PRDV1/Manual_BJP/README.md

# Manual_BJP
Manual binder jet 3D printer designed to enable small-scale research, multi-material structures, and interchangeable binder deposition methods
