PRDV1/Manual_BJP/CAD_files/II. Ink-Cartridge_Top_Plate/Ink-Cartridge_top_plate_assembly.SLDASM

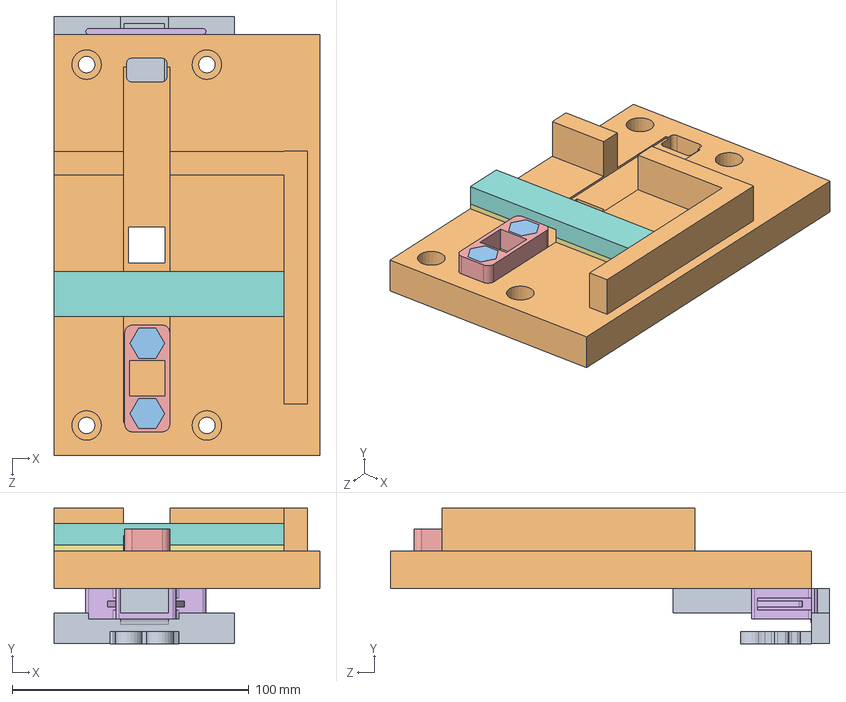
[picture p5: CAD file, 2024-03-27]
CAD_files/II. Ink-Cartridge_Top_Plate/Ink-Cartridge_top_plate_assembly.SLDASM
112.2 x 57.2 x 185.4 mm
Ink-Cartridge_Top_Plate
Brass_insert_powder_carriage x 2
Felt_powder_carriage
Powder_carriage
Felt_powder_spreader_Ink-Cartridge
Powder_spreader_Ink-Cartridge
Powder_catcher_short_both
