PRDV1/Manual_BJP/CAD_files/III. Stage_Assembly/Stage_assembly_support_4108.SLDPRT

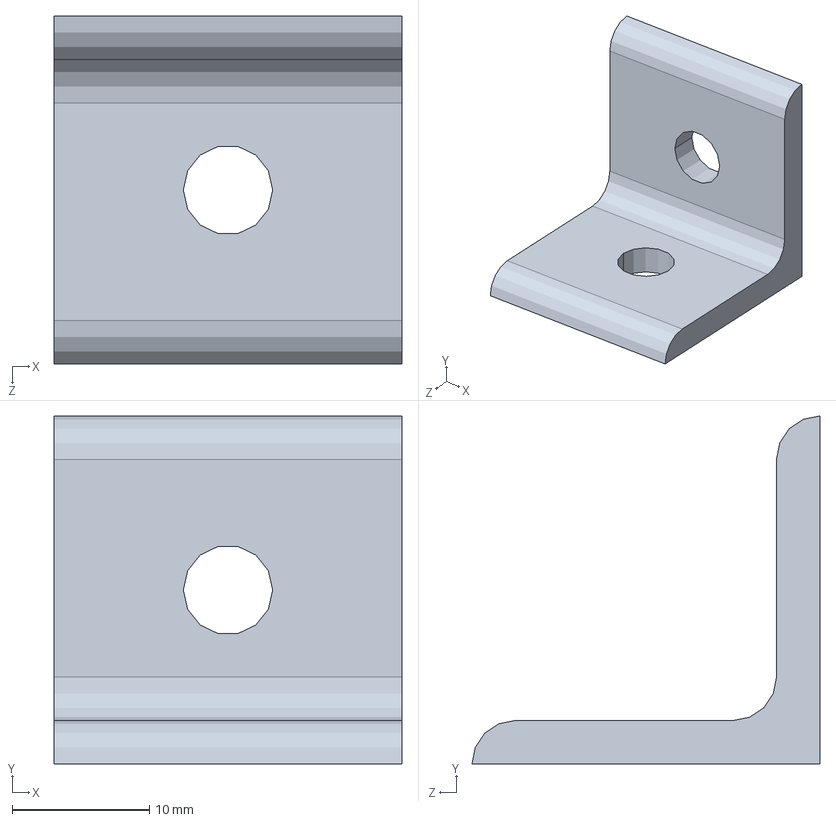
[picture p6: CAD file, 2024-03-27]
CAD_files/III. Stage_Assembly/Stage_assembly_support_4108.SLDPRT
25.4 x 25.4 x 25.4 mm
