PRDV1/Manual_BJP/STL_files/I. Spray_Top_Plate/Spray_top_plate_assembly-Powder_carriage_assembly-1 Powder_carriage.STL

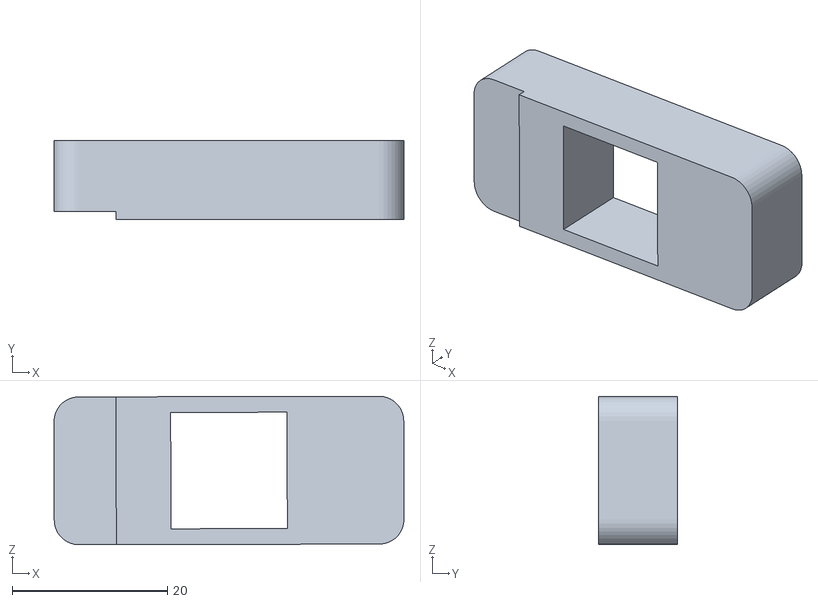
[picture p7: CAD file, 2024-03-27]
STL_files/I. Spray_Top_Plate/Spray_top_plate_assembly-Powder_carriage_assembly-1 Powder_carriage.STL
45.1 x 10.2 x 19.1
