PRDV1/Manual_BJP/STL_files/II. Ink-Cartridge_Top_Plate/Ink-Cartridge_top_plate_assembly-Powder_spreader_Ink-Cartridge_assembly-1 Felt_powder_spreader_Ink-Cartridge.STL

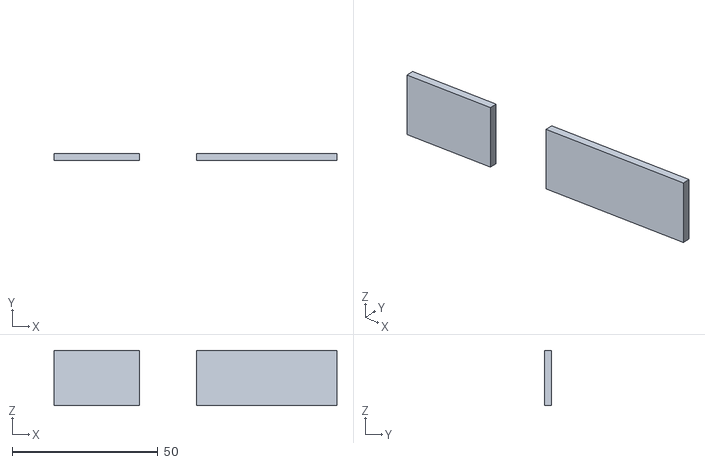
[picture p8: CAD file, 2024-03-27]
STL_files/II. Ink-Cartridge_Top_Plate/Ink-Cartridge_top_plate_assembly-Powder_spreader_Ink-Cartridge_assembly-1 Felt_powder_spreader_Ink-Cartridge.STL
97.0 x 2.50 x 19.0
