PRDV1/Manual_BJP/STL_files/III. Stage_Assembly/Stage_assembly-Steel_ball.STL

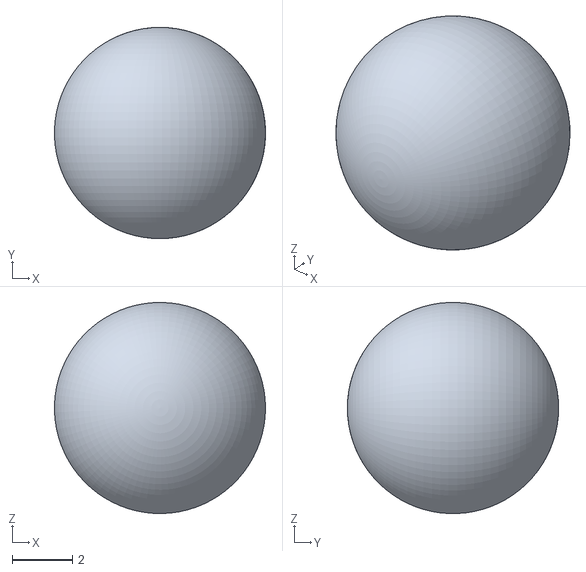
[picture p9: CAD file, 2024-03-27]
STL_files/III. Stage_Assembly/Stage_assembly-Steel_ball.STL
6.99 x 7.00 x 6.99
