PRDV1/Manual_BJP/STL_files/IV. Heat_lamp/Heat_lamp_assembly-Lamp.STL

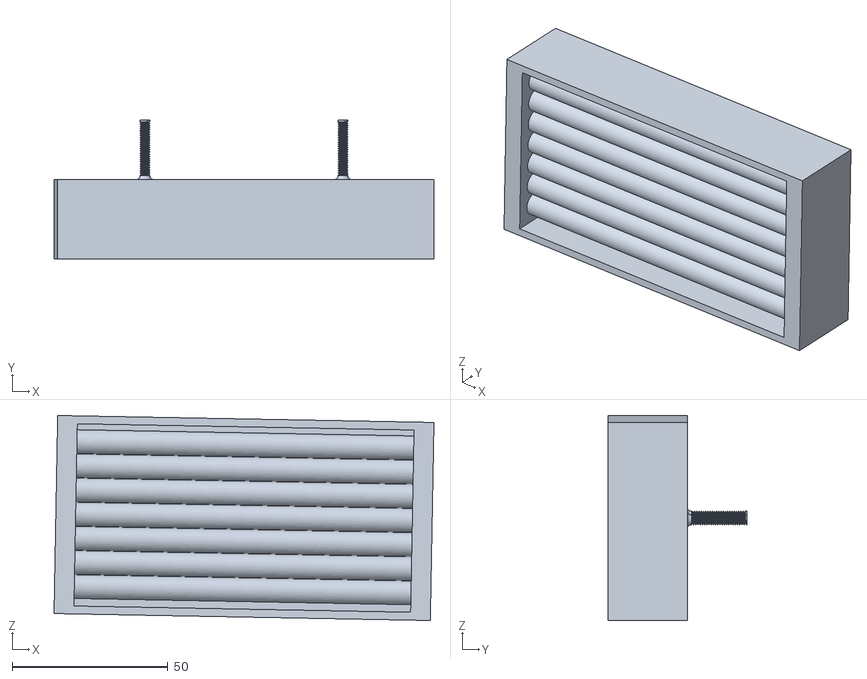
[picture p10: CAD file, 2024-03-27]
STL_files/IV. Heat_lamp/Heat_lamp_assembly-Lamp.STL
121.8 x 44.5 x 65.7
