PRDV1/Manual_BJP/STL_files/Stage/Frame_assembly-Base.STL

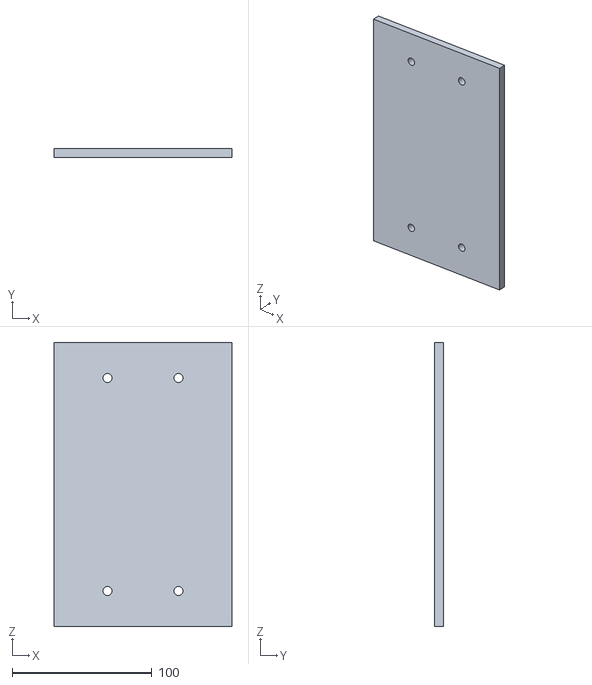
[picture p11: CAD file, 2024-03-27]
STL_files/Stage/Frame_assembly-Base.STL
127.0 x 6.35 x 203.2
