PRDV1/Manual_BJP/STL_files/V. Transfer_Assembly/Transfer_assembly-Transfer_slider.STL

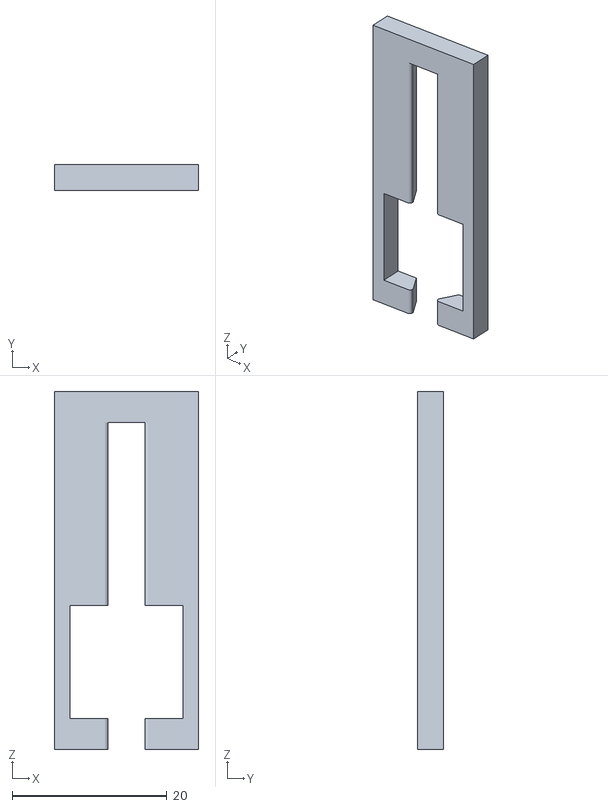
[picture p12: CAD file, 2024-03-27]
STL_files/V. Transfer_Assembly/Transfer_assembly-Transfer_slider.STL
18.6 x 3.40 x 46.2
