PRDV1/Manual_BJP/CAD_files/I. Spray_Top_Plate/Spray_top_plate_assembly.SLDASM

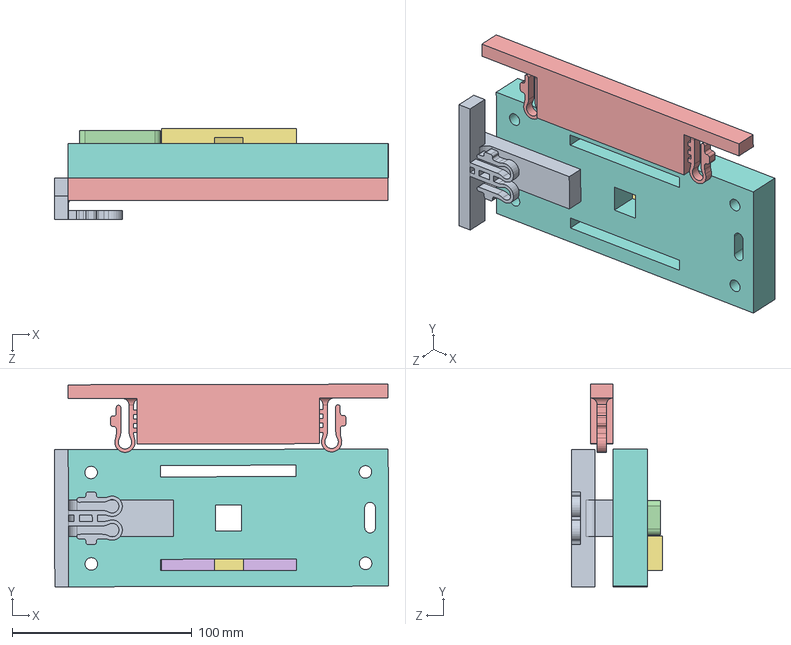
[picture p13: CAD file, 2024-03-27]
CAD_files/I. Spray_Top_Plate/Spray_top_plate_assembly.SLDASM
185.6 x 112.7 x 50.8 mm
Brass_insert_powder_carriage x 2
Felt_powder_carriage
Powder_carriage
Powder_catcher_long_Spray
Felt_powder_spreader_Spray
Powder_spreader_Spray
Spray_top_plate
Powder_catcher_short_both
