PRDV1/Manual_BJP/CAD_files/IV. Heat_lamp/Heat_lamp_assembly.SLDASM

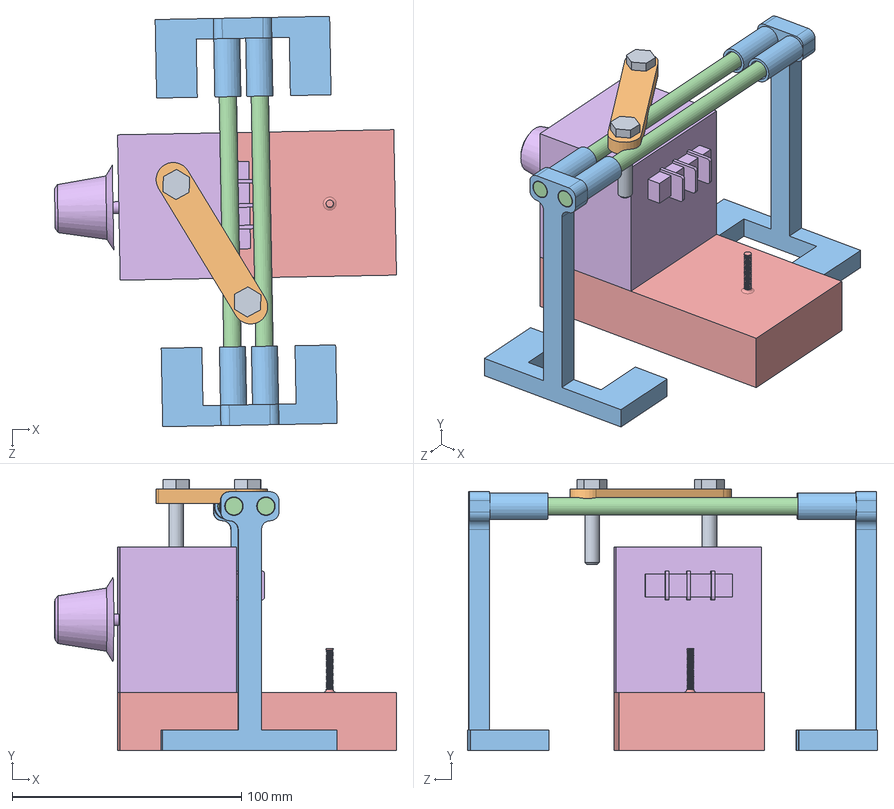
[picture p14: CAD file, 2024-03-27]
CAD_files/IV. Heat_lamp/Heat_lamp_assembly.SLDASM
149.3 x 118.4 x 179.2 mm
Bolt_heat_lamp x 2
Heat_lamp_standholder
Heat_lamp_standpost x 2
Heat_lamp_standrod x 2
Lamp
Lamp_voltage_regulator
