PRDV1/Manual_BJP/CAD_files/Stage/Frame_assembly2.SLDASM

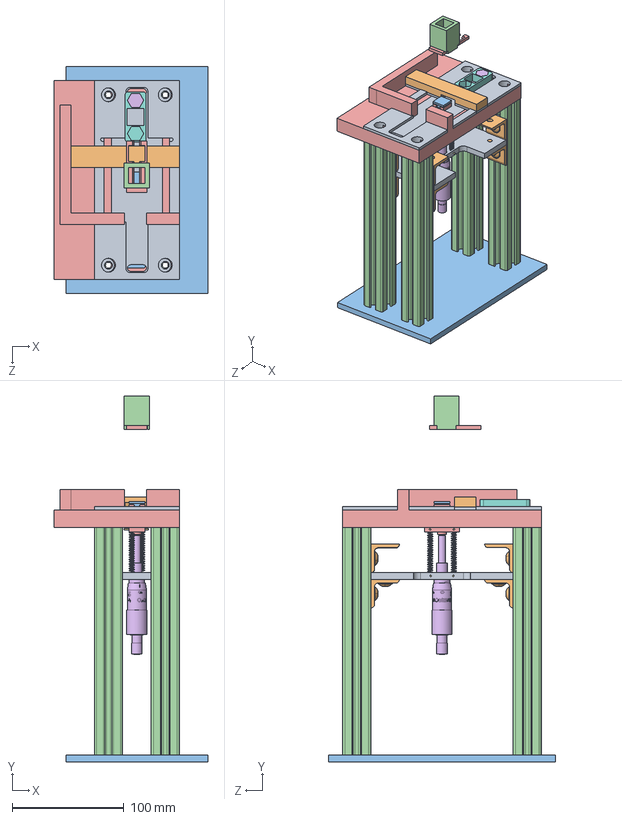
[picture p15: CAD file, 2024-03-27]
CAD_files/Stage/Frame_assembly2.SLDASM
137.6 x 327.3 x 203.2 mm
Base
Railed_post x 4
Build_bed_support
Mitutoyo Micrometer 150-831
Pin_stage_assembly x 4
Spring x 2
Stage_assembly_platform
Stage_assembly_screw_3390 x 12
Stage_assembly_slider_3382 x 8
Stage_assembly_support_4108 x 8
Stee_ball
Build_plate
Spray_top_plate
