PRDV1/Manual_BJP/STL_files/I. Spray_Top_Plate/Spray_top_plate_assembly-Spray_top_plate.STL

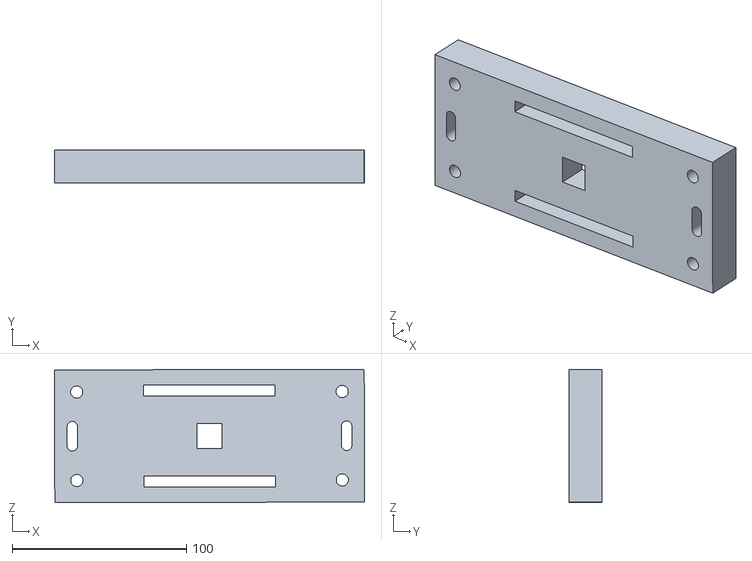
[picture p16: CAD file, 2024-03-27]
STL_files/I. Spray_Top_Plate/Spray_top_plate_assembly-Spray_top_plate.STL
178.0 x 19.0 x 76.6
