PRDV1/Manual_BJP/STL_files/III. Stage_Assembly/Stage_assembly-Pin_stage_assembly.STL

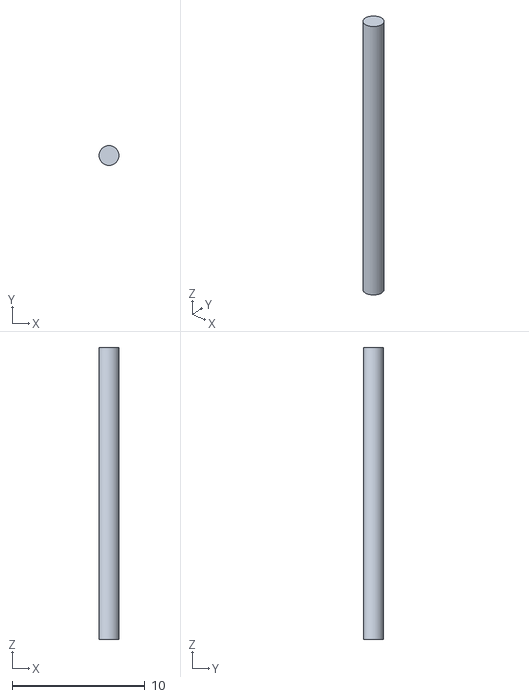
[picture p17: CAD file, 2024-03-27]
STL_files/III. Stage_Assembly/Stage_assembly-Pin_stage_assembly.STL
1.50 x 1.50 x 22.0
