PRDV1/Manual_BJP/STL_files/IV. Heat_lamp/Heat_lamp_assembly-Heat_lamp_standpost.STL

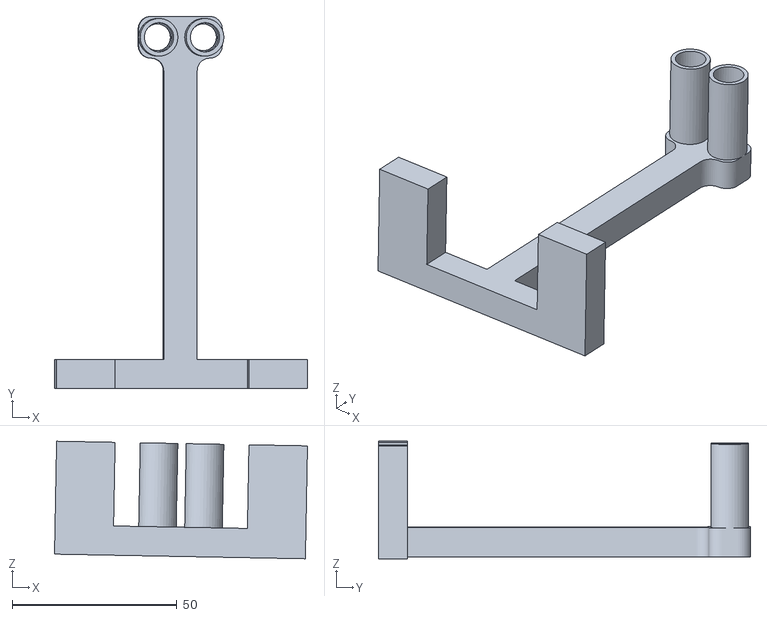
[picture p18: CAD file, 2024-03-27]
STL_files/IV. Heat_lamp/Heat_lamp_assembly-Heat_lamp_standpost.STL
76.8 x 113.0 x 35.7
