PRDV1/Manual_BJP/STL_files/Stage/Frame_assembly-slider_3382.STL

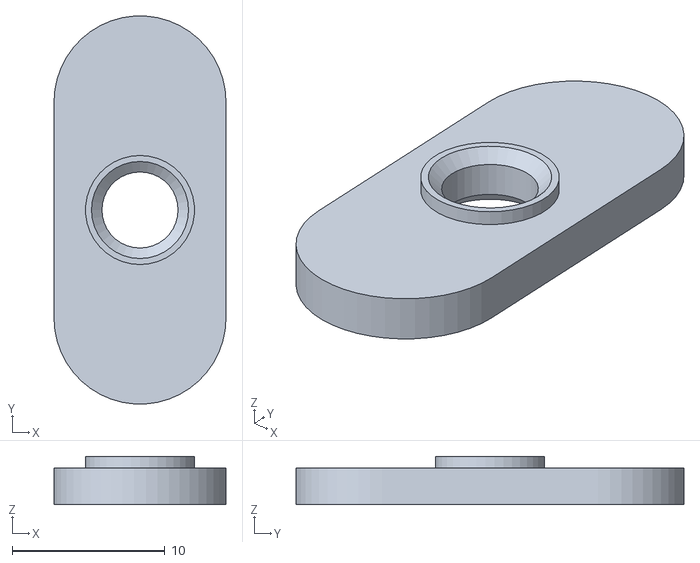
[picture p19: CAD file, 2024-03-27]
STL_files/Stage/Frame_assembly-slider_3382.STL
11.3 x 25.4 x 3.15
