PRDV1/Manual_BJP/STL_files/V. Transfer_Assembly/Transfer_assembly-Transfer_box.STL

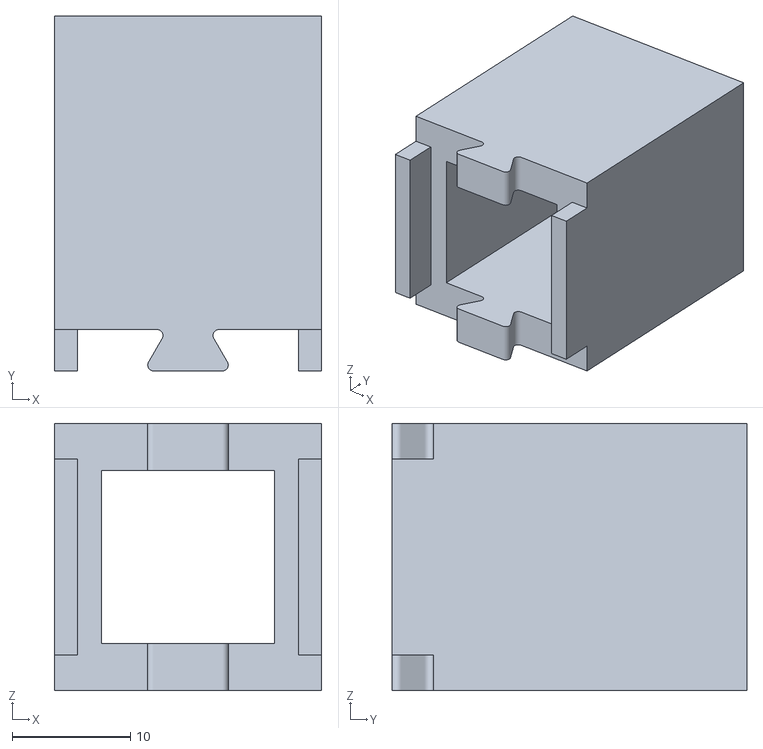
[picture p20: CAD file, 2024-03-27]
STL_files/V. Transfer_Assembly/Transfer_assembly-Transfer_box.STL
22.6 x 30.0 x 22.6
