PRDV1/Manual_BJP/STL_files/II. Ink-Cartridge_Top_Plate/Ink-Cartridge_top_plate_assembly-Ink-Cartridge_Top_Plate.STL

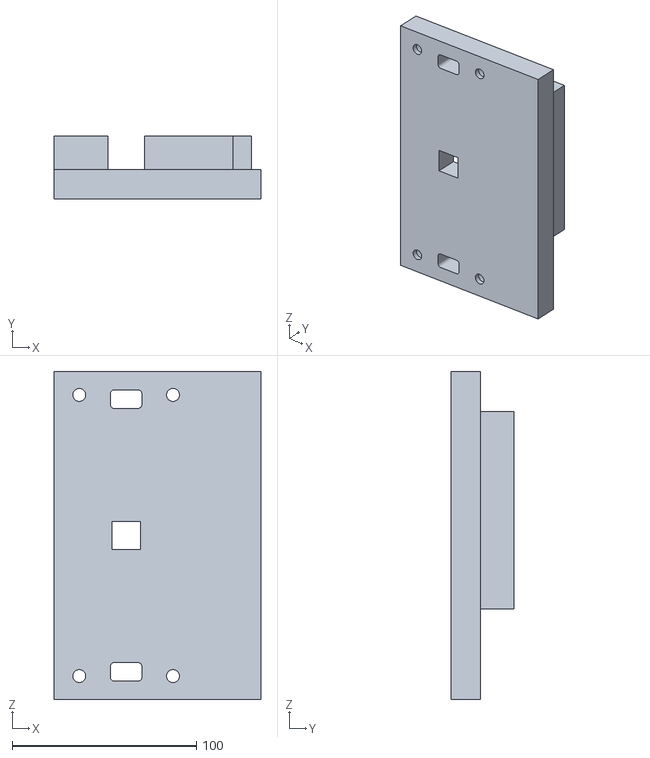
[picture p23: CAD file, 2024-03-27]
STL_files/II. Ink-Cartridge_Top_Plate/Ink-Cartridge_top_plate_assembly-Ink-Cartridge_Top_Plate.STL
112.2 x 34.0 x 177.8
