PRDV1/Manual_BJP/STL_files/V. Transfer_Assembly/Transfer_assembly-Build_plate.STL

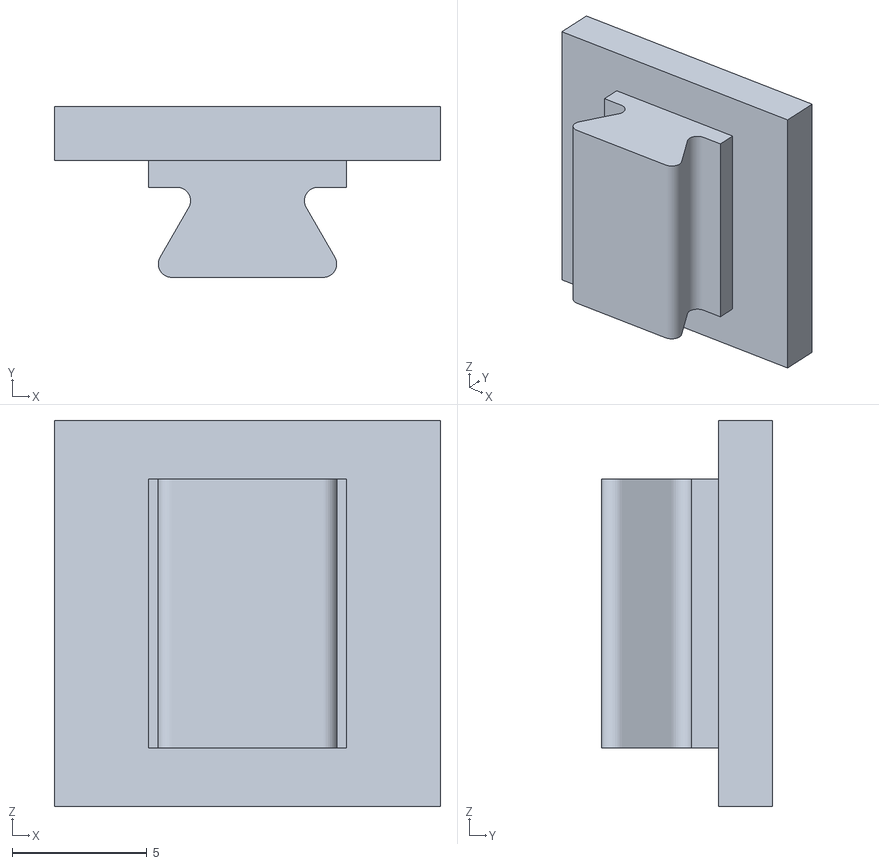
[picture p24: CAD file, 2024-03-27]
STL_files/V. Transfer_Assembly/Transfer_assembly-Build_plate.STL
14.3 x 6.35 x 14.4
