PRDV1/Manual_BJP/CAD_files/I. Spray_Top_Plate/Powder_deposition_and_spreading/Powder_spreader_Spray_assembly.SLDASM

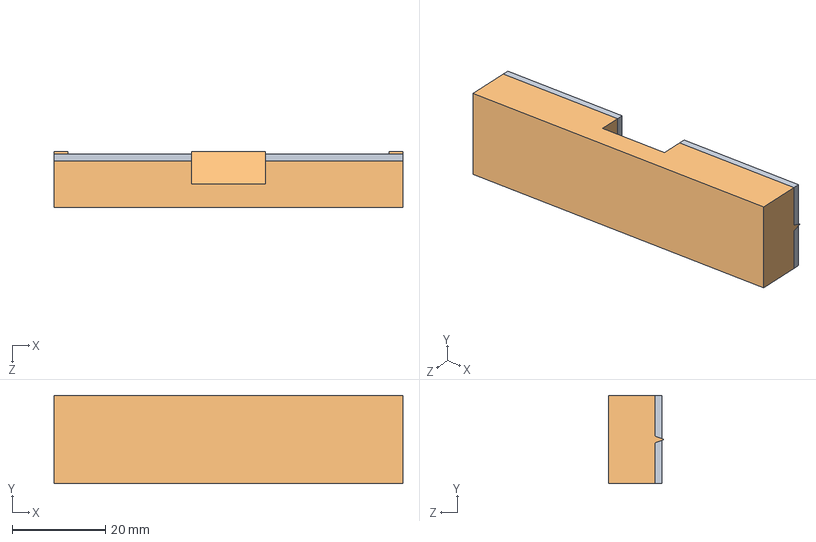
[picture p25: CAD file, 2024-03-27]
CAD_files/I. Spray_Top_Plate/Powder_deposition_and_spreading/Powder_spreader_Spray_assembly.SLDASM
75.0 x 19.0 x 12.0 mm
Felt_powder_spreader_Spray
Powder_spreader_Spray
