PRDV1/Manual_BJP/CAD_files/Stage/support_assembly.SLDASM

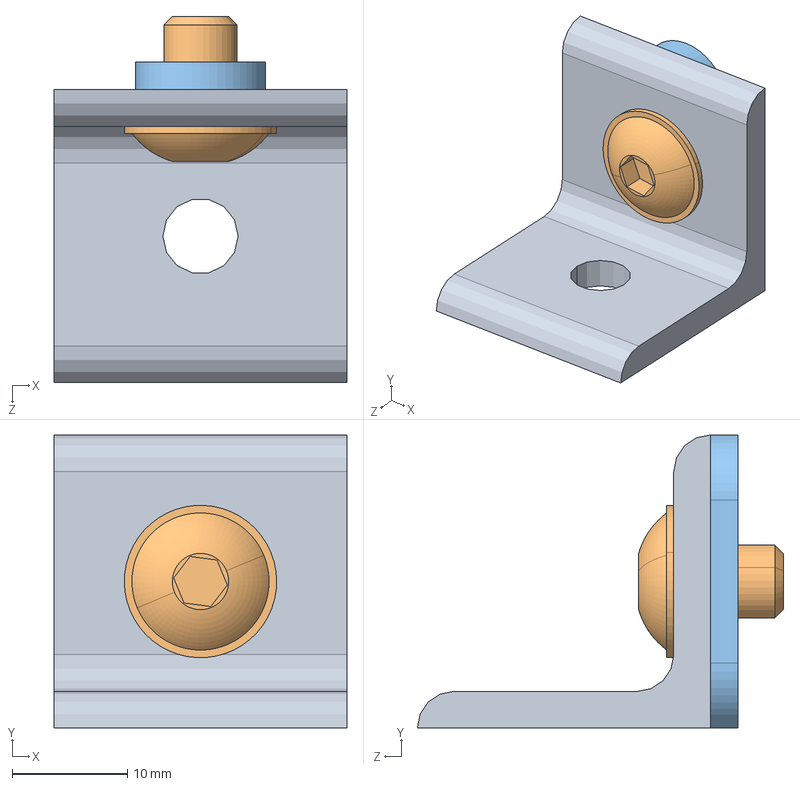
[picture p26: CAD file, 2024-03-27]
CAD_files/Stage/support_assembly.SLDASM
25.4 x 25.4 x 31.7 mm
Stage_assembly_screw_3390
Stage_assembly_slider_3382
Stage_assembly_support_4108
