PRDV1/Manual_BJP/CAD_files/V. Transfer_Assembly/Transfer_assembly.SLDASM

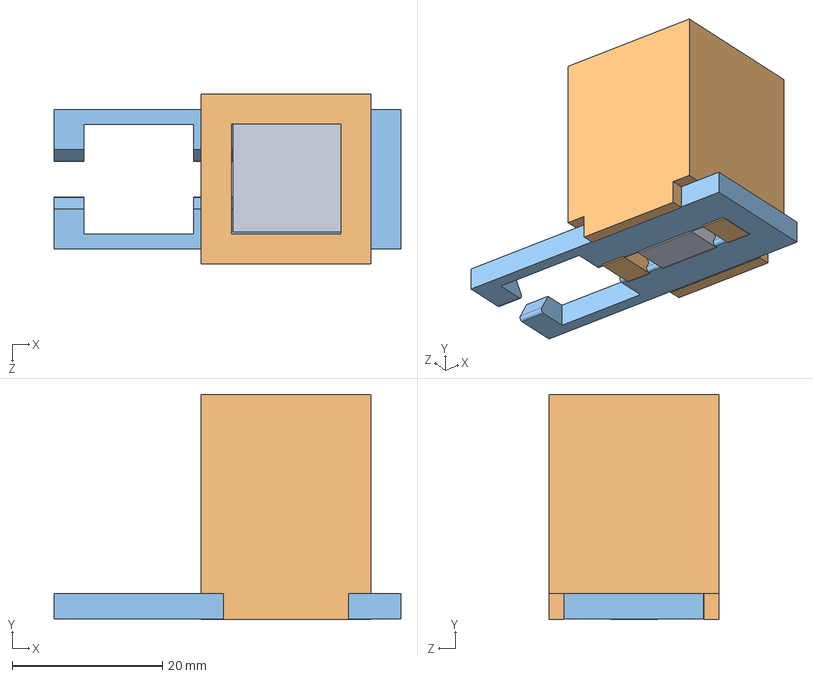
[picture p27: CAD file, 2024-03-27]
CAD_files/V. Transfer_Assembly/Transfer_assembly.SLDASM
46.2 x 30.0 x 22.6 mm
Build_plate
Transfer_box
Transfer_slider
