PRDV1/Manual_BJP/STL_files/I. Spray_Top_Plate/Spray_top_plate_assembly-Powder_spreader_Spray_assembly-1 Felt_powder_spreader_Spray.STL

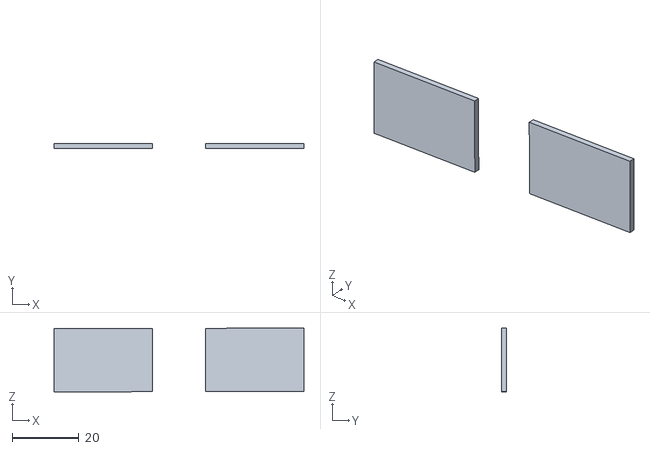
[picture p28: CAD file, 2024-03-27]
STL_files/I. Spray_Top_Plate/Spray_top_plate_assembly-Powder_spreader_Spray_assembly-1 Felt_powder_spreader_Spray.STL
75.0 x 1.50 x 19.2
