PRDV1/Manual_BJP/STL_files/II. Ink-Cartridge_Top_Plate/Ink-Cartridge_top_plate_assembly-Powder_carriage_assembly-1 Brass_insert_powder_carriage.STL

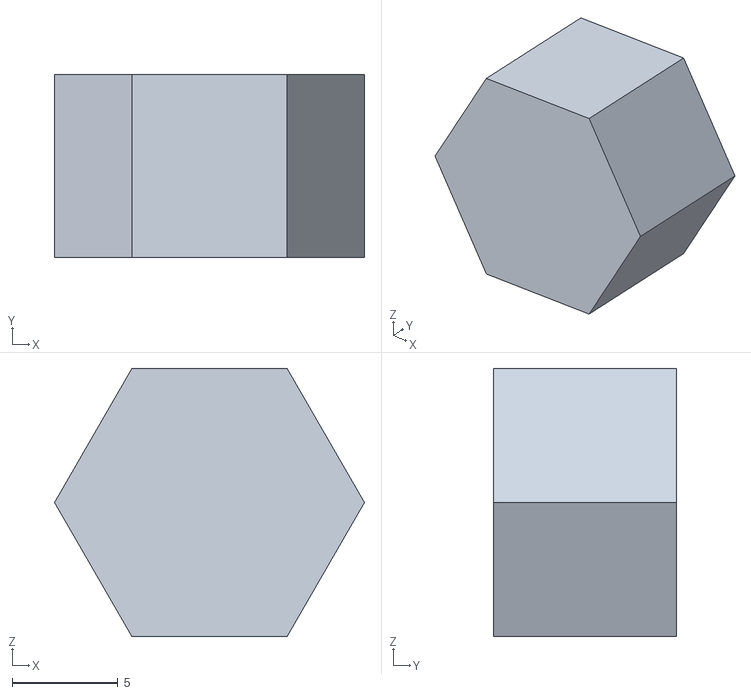
[picture p29: CAD file, 2024-03-27]
STL_files/II. Ink-Cartridge_Top_Plate/Ink-Cartridge_top_plate_assembly-Powder_carriage_assembly-1 Brass_insert_powder_carriage.STL
14.7 x 8.64 x 12.7
