PRDV1/Manual_BJP/STL_files/IV. Heat_lamp/Heat_lamp_assembly-Heat_lamp_standholder.STL

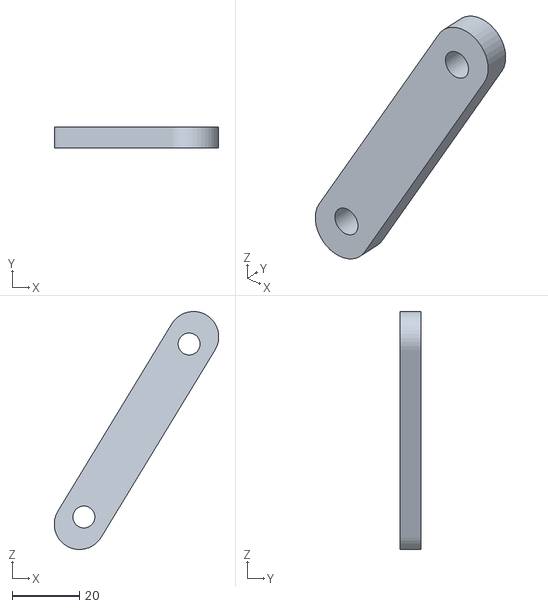
[picture p30: CAD file, 2024-03-27]
STL_files/IV. Heat_lamp/Heat_lamp_assembly-Heat_lamp_standholder.STL
48.7 x 6.35 x 70.5
