PRDV1/Manual_BJP/STL_files/Stage/Frame_assembly-Railed_post.STL

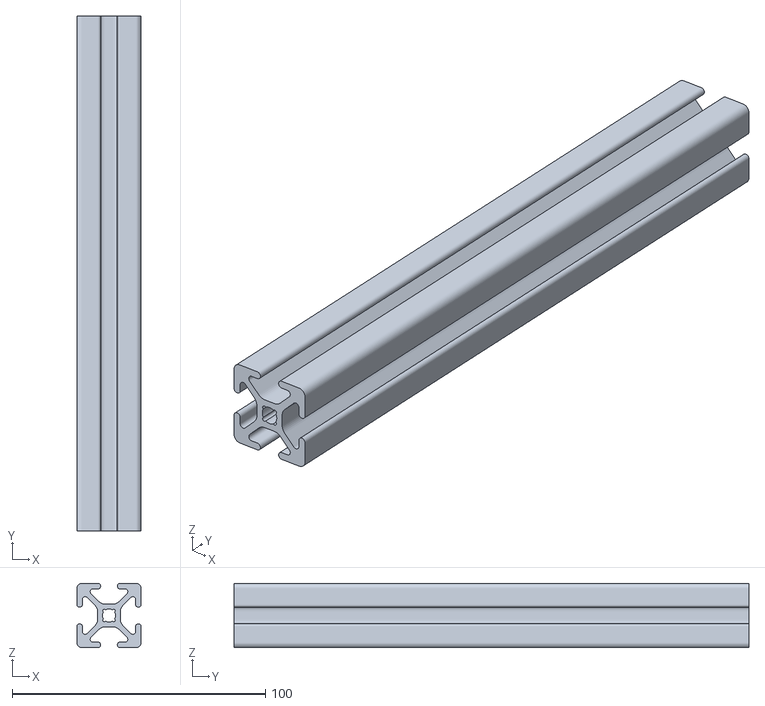
[picture p31: CAD file, 2024-03-27]
STL_files/Stage/Frame_assembly-Railed_post.STL
25.4 x 203.2 x 25.4
