PRDV1/Manual_BJP/CAD_files/II. Ink-Cartridge_Top_Plate/Powder_deposition_and_spreading/Powder_spreader_Ink-Cartridge_assembly.SLDASM

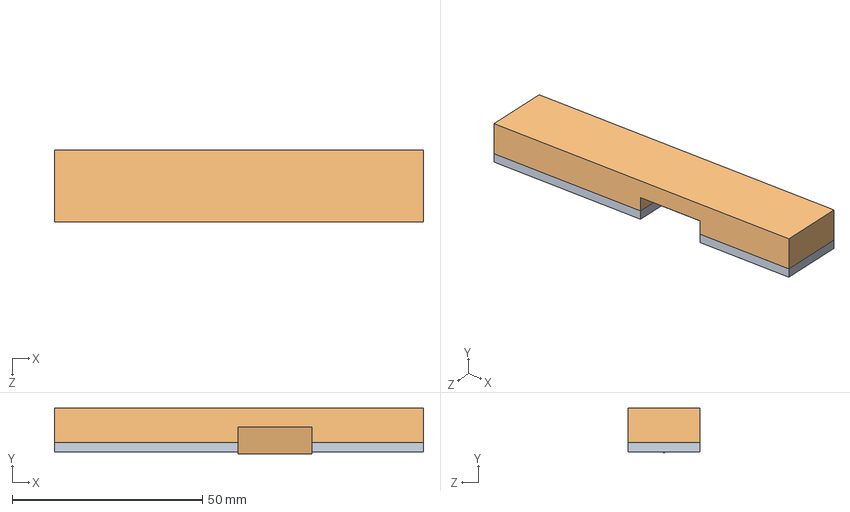
[picture p32: CAD file, 2024-03-27]
CAD_files/II. Ink-Cartridge_Top_Plate/Powder_deposition_and_spreading/Powder_spreader_Ink-Cartridge_assembly.SLDASM
97.0 x 12.0 x 19.0 mm
Felt_powder_spreader_Ink-Cartridge
Powder_spreader_Ink-Cartridge
