PRDV1/Manual_BJP/STL_files/I. Spray_Top_Plate/Spray_top_plate_assembly-Powder_catcher_long_Spray.STL

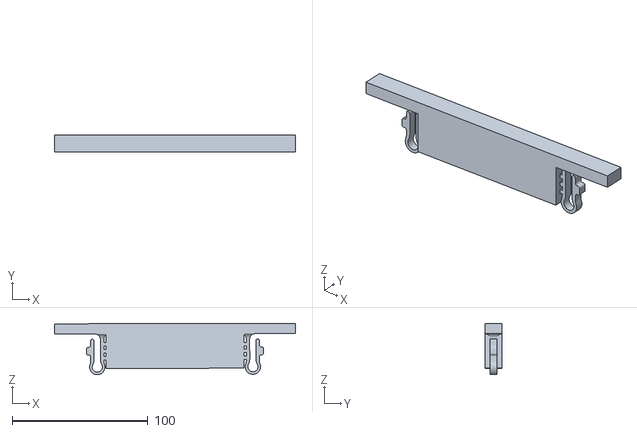
[picture p33: CAD file, 2024-03-27]
STL_files/I. Spray_Top_Plate/Spray_top_plate_assembly-Powder_catcher_long_Spray.STL
177.8 x 12.7 x 37.9
