PRDV1/Manual_BJP/STL_files/II. Ink-Cartridge_Top_Plate/Ink-Cartridge_top_plate_assembly-Powder_spreader_Ink-Cartridge_assembly-1 Powder_spreader_Ink-Cartridge.STL

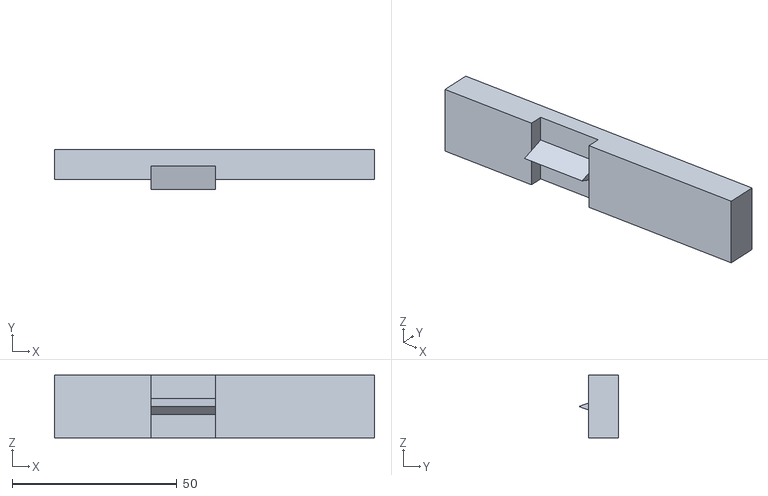
[picture p34: CAD file, 2024-03-27]
STL_files/II. Ink-Cartridge_Top_Plate/Ink-Cartridge_top_plate_assembly-Powder_spreader_Ink-Cartridge_assembly-1 Powder_spreader_Ink-Cartridge.STL
97.0 x 12.0 x 19.0
