PRDV1/Manual_BJP/STL_files/III. Stage_Assembly/Stage_assembly-Mitutoyo Micrometer 150-831.STL

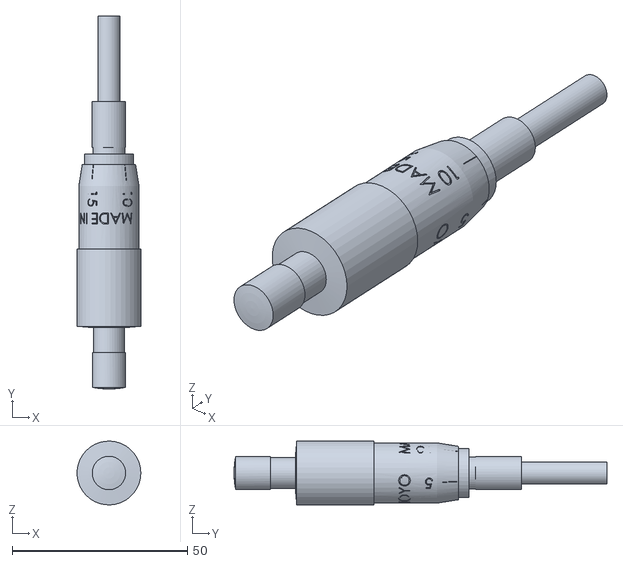
[picture p35: CAD file, 2024-03-27]
STL_files/III. Stage_Assembly/Stage_assembly-Mitutoyo Micrometer 150-831.STL
18.2 x 106.3 x 18.2
