PRDV1/Manual_BJP/STL_files/IV. Heat_lamp/Heat_lamp_assembly-Heat_lamp_standrod.STL

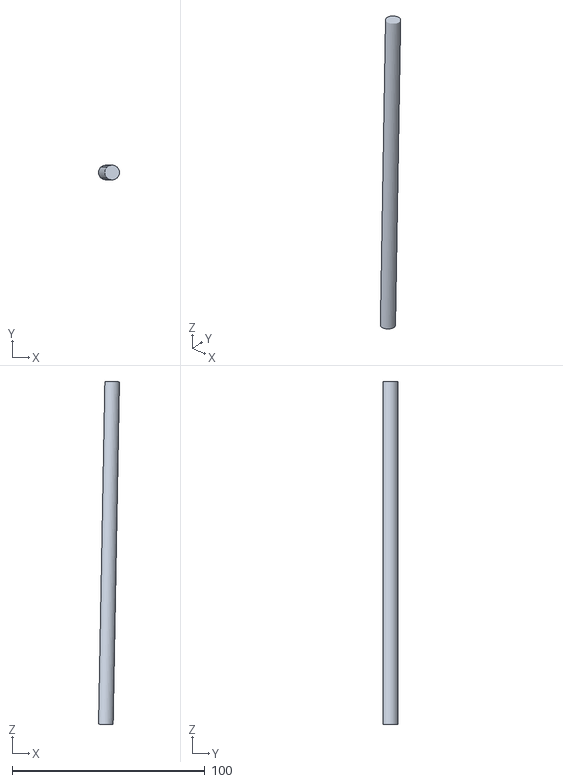
[picture p36: CAD file, 2024-03-27]
STL_files/IV. Heat_lamp/Heat_lamp_assembly-Heat_lamp_standrod.STL
10.9 x 7.61 x 177.9
