PRDV1/Manual_BJP/CAD_files/I. Spray_Top_Plate/Powder_deposition_and_spreading/Powder_carriage_assembly.SLDASM

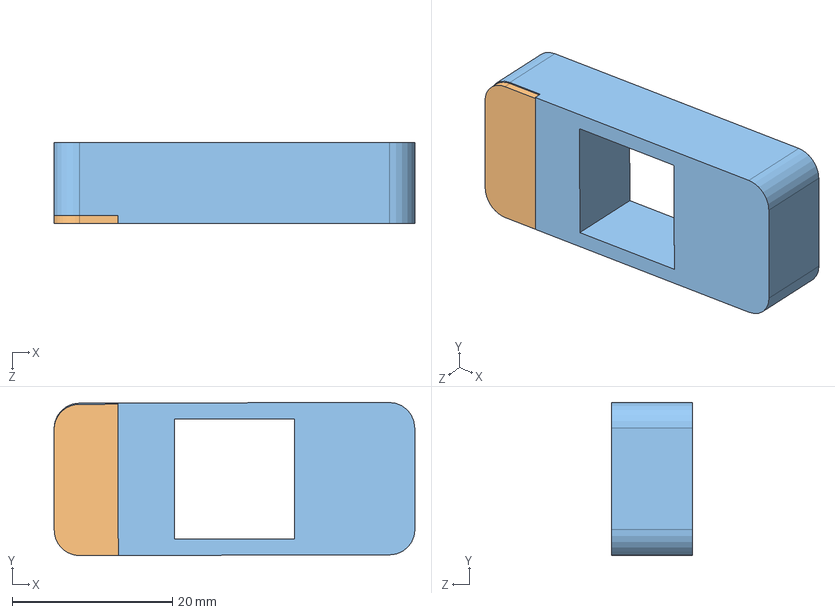
[picture p37: CAD file, 2024-03-27]
CAD_files/I. Spray_Top_Plate/Powder_deposition_and_spreading/Powder_carriage_assembly.SLDASM
45.1 x 19.1 x 10.2 mm
Brass_insert_powder_carriage x 2
Felt_powder_carriage
Powder_carriage
