PRDV1/Manual_BJP/STL_files/I. Spray_Top_Plate/Spray_top_plate_assembly-Powder_carriage_assembly-1 Felt_powder_carriage.STL

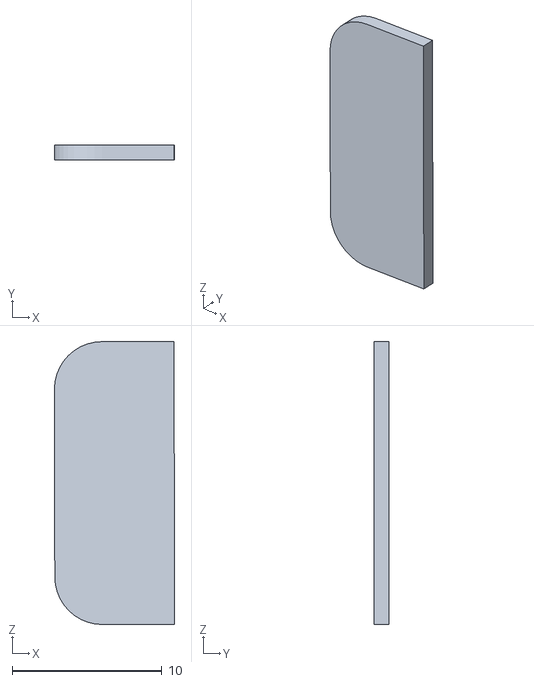
[picture p38: CAD file, 2024-03-27]
STL_files/I. Spray_Top_Plate/Spray_top_plate_assembly-Powder_carriage_assembly-1 Felt_powder_carriage.STL
8.03 x 1.00 x 18.9
