PRDV1/Manual_BJP/STL_files/II. Ink-Cartridge_Top_Plate/Ink-Cartridge_top_plate_assembly-Powder_catcher_short_both.STL

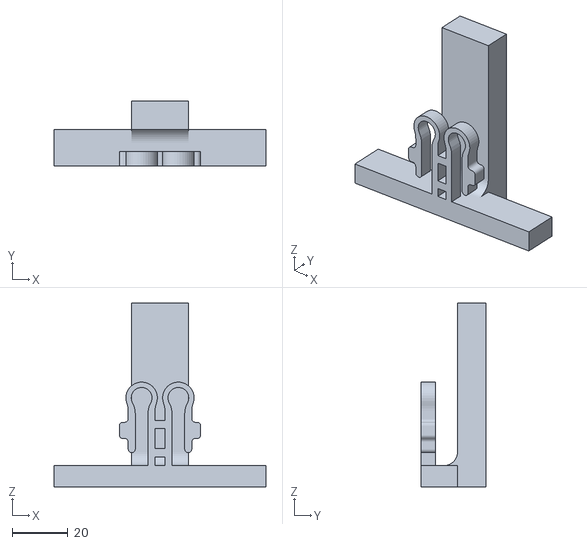
[picture p39: CAD file, 2024-03-27]
STL_files/II. Ink-Cartridge_Top_Plate/Ink-Cartridge_top_plate_assembly-Powder_catcher_short_both.STL
76.2 x 23.2 x 66.0
