PRDV1/Manual_BJP/STL_files/III. Stage_Assembly/Stage_assembly-Build_bed_support.STL

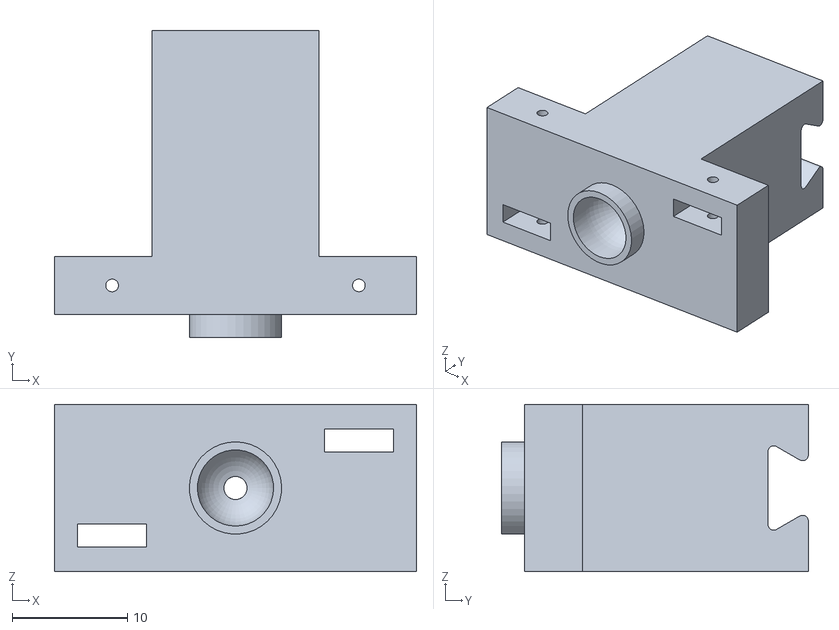
[picture p40: CAD file, 2024-03-27]
STL_files/III. Stage_Assembly/Stage_assembly-Build_bed_support.STL
31.4 x 26.6 x 14.5
