PRDV1/Manual_BJP/STL_files/IV. Heat_lamp/Heat_lamp_assembly-Lamp_voltage_regulator.STL

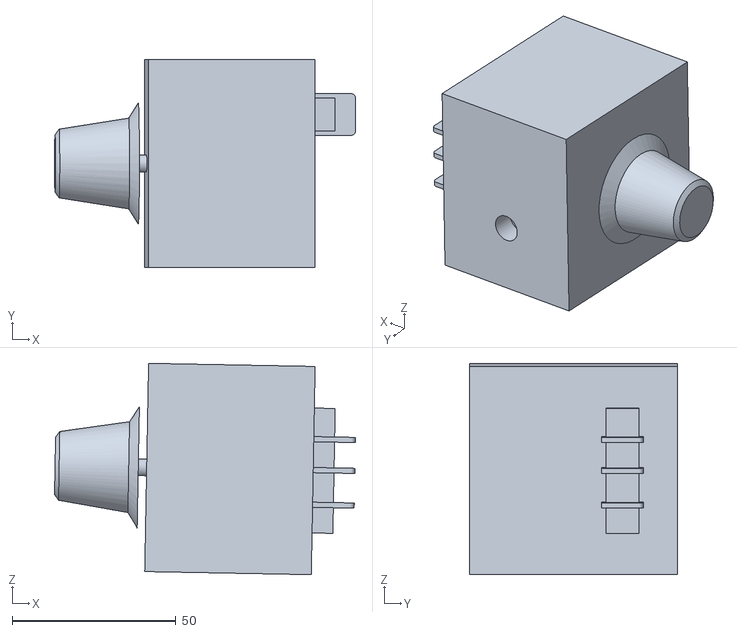
[picture p41: CAD file, 2024-03-27]
STL_files/IV. Heat_lamp/Heat_lamp_assembly-Lamp_voltage_regulator.STL
91.8 x 63.5 x 64.4
