PRDV1/Manual_BJP/CAD_files/III. Stage_Assembly/Stage_assembly_platform.SLDPRT

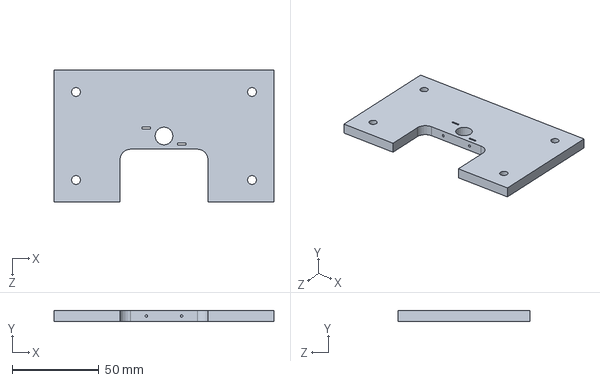
[picture p42: CAD file, 2024-03-27]
CAD_files/III. Stage_Assembly/Stage_assembly_platform.SLDPRT
127.0 x 6.35 x 76.2 mm
