PRDV1/Manual_BJP/CAD_files/III. Stage_Assembly/Stage_assembly.SLDASM

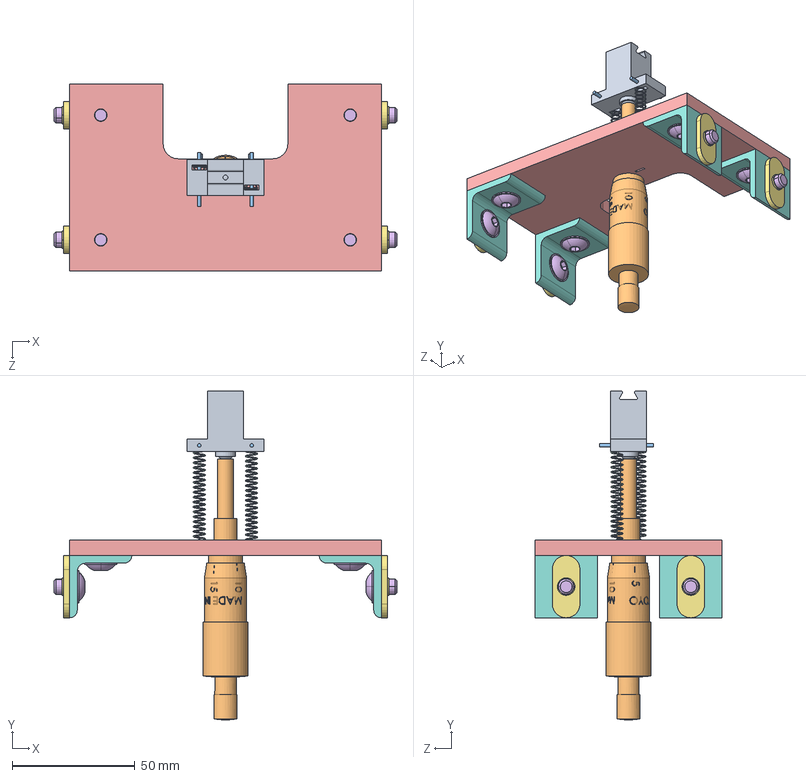
[picture p43: CAD file, 2024-03-27]
CAD_files/III. Stage_Assembly/Stage_assembly.SLDASM
139.7 x 133.9 x 76.2 mm
Build_bed_support
Mitutoyo Micrometer 150-831
Pin_stage_assembly x 4
Spring x 2
Stage_assembly_platform
Stage_assembly_screw_3390 x 8
Stage_assembly_slider_3382 x 4
Stage_assembly_support_4108 x 4
Stee_ball
