PRDV1/Manual_BJP/STL_files/III. Stage_Assembly/Stage_assembly-Spring.STL

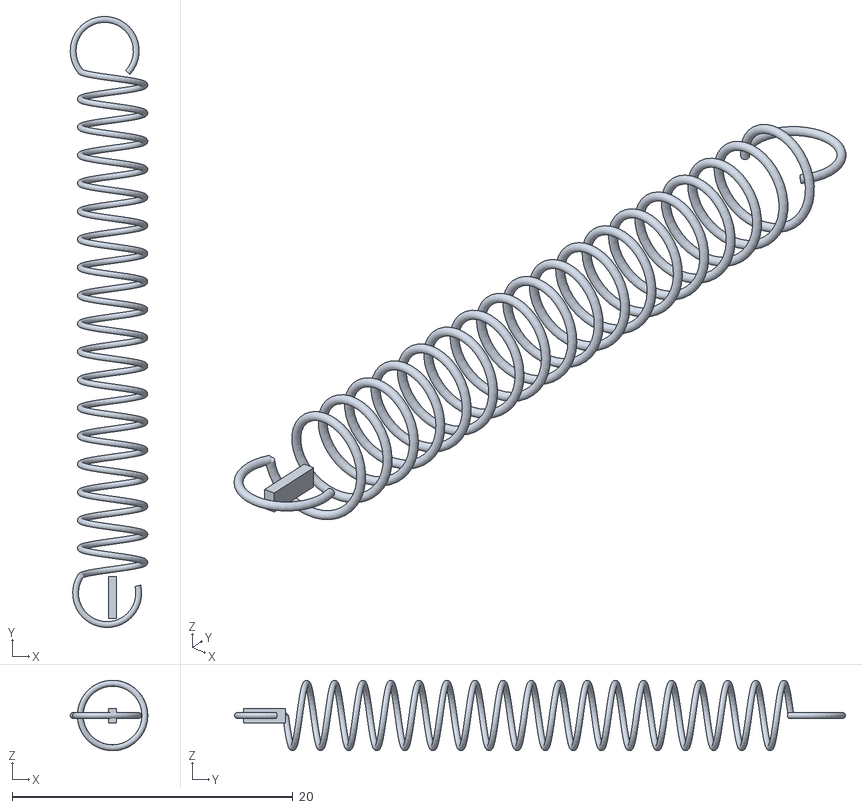
[picture p44: CAD file, 2024-03-27]
STL_files/III. Stage_Assembly/Stage_assembly-Spring.STL
5.53 x 43.5 x 5.02
