PRDV1/Manual_BJP/CAD_files/I. Spray_Top_Plate/Spray_top_plate.SLDPRT

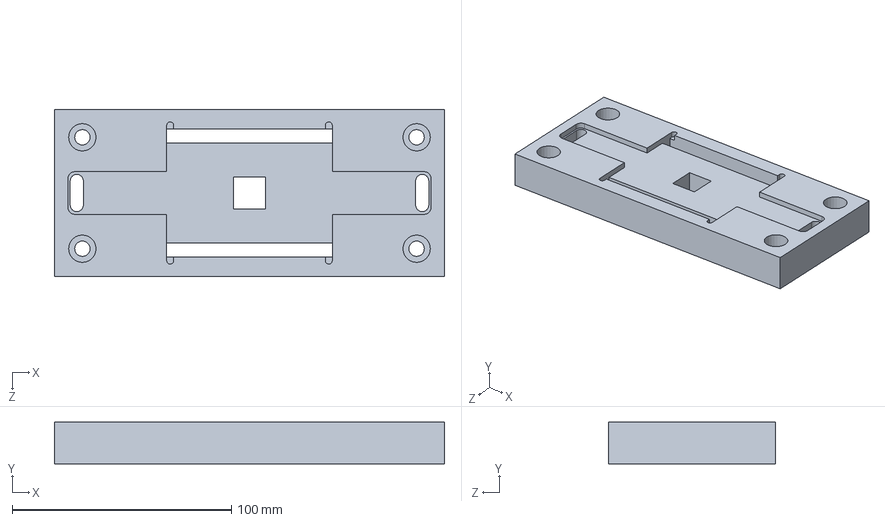
[picture p45: CAD file, 2024-03-27]
CAD_files/I. Spray_Top_Plate/Spray_top_plate.SLDPRT
177.8 x 19.1 x 76.2 mm
