PRDV1/Manual_BJP/CAD_files/IV. Heat_lamp/Lamp_voltage_regulator.SLDPRT

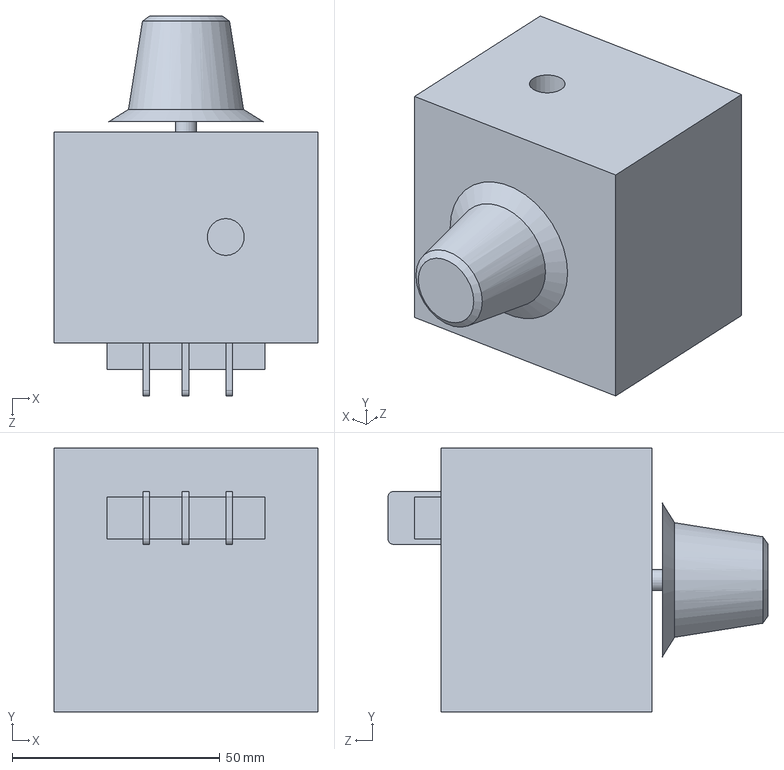
[picture p46: CAD file, 2024-03-27]
CAD_files/IV. Heat_lamp/Lamp_voltage_regulator.SLDPRT
63.5 x 63.5 x 91.4 mm
