PRDV1/Manual_BJP/CAD_files/V. Transfer_Assembly/Build_plate.SLDPRT

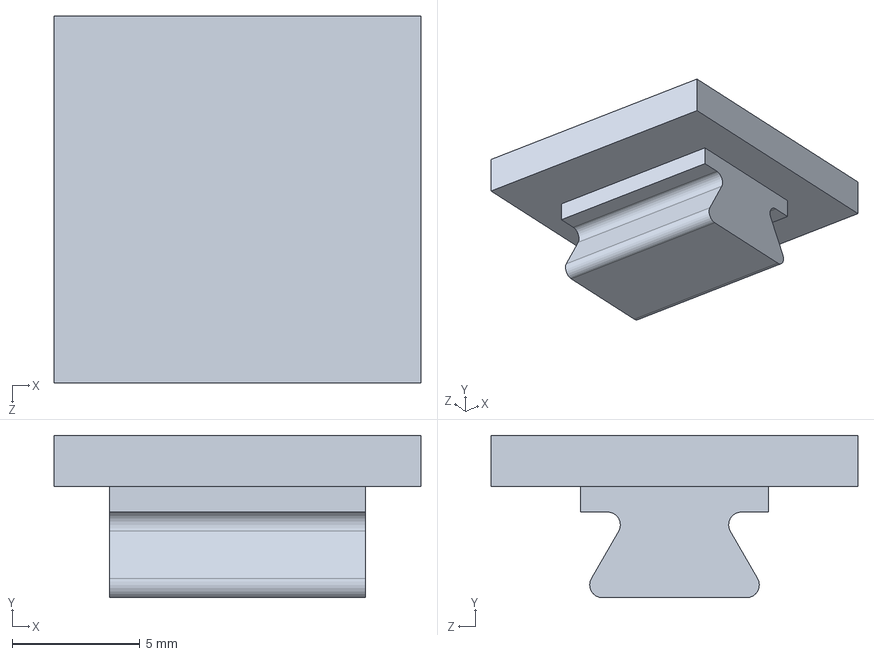
[picture p47: CAD file, 2024-03-27]
CAD_files/V. Transfer_Assembly/Build_plate.SLDPRT
14.3 x 6.35 x 14.3 mm
