PRDV1/Manual_BJP/CAD_files/IV. Heat_lamp/Heat_lamp_standrod.SLDPRT

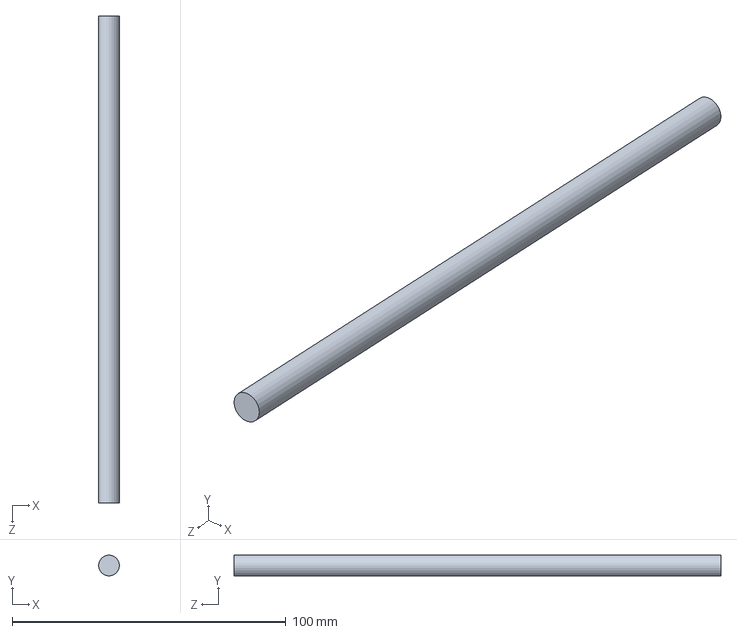
[picture p48: CAD file, 2024-03-27]
CAD_files/IV. Heat_lamp/Heat_lamp_standrod.SLDPRT
7.62 x 7.62 x 177.8 mm
