PRDV1/Manual_BJP/CAD_files/IV. Heat_lamp/Lamp.SLDPRT

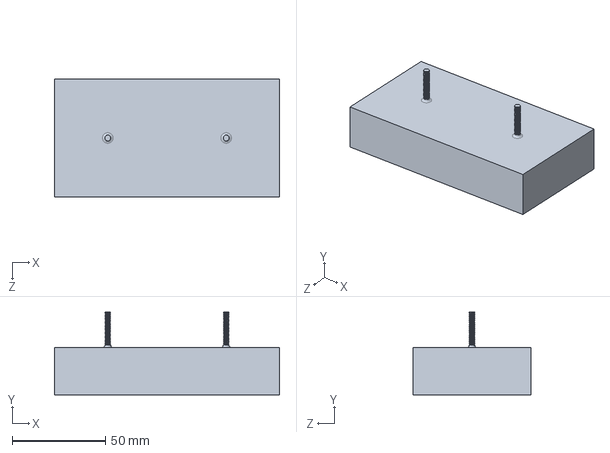
[picture p49: CAD file, 2024-03-27]
CAD_files/IV. Heat_lamp/Lamp.SLDPRT
120.7 x 44.5 x 63.5 mm
