PRDV1/Manual_BJP/CAD_files/IV. Heat_lamp/Heat_lamp_standpost.SLDPRT

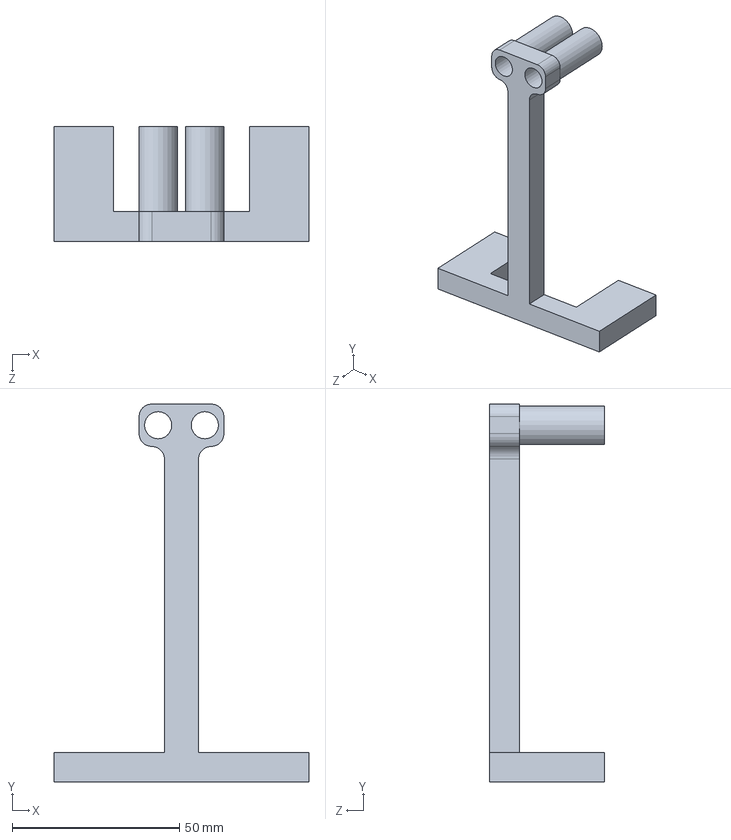
[picture p50: CAD file, 2024-03-27]
CAD_files/IV. Heat_lamp/Heat_lamp_standpost.SLDPRT
76.2 x 113.0 x 34.3 mm
