PRDV1/Manual_BJP/CAD_files/Stage/Railed_post.SLDPRT

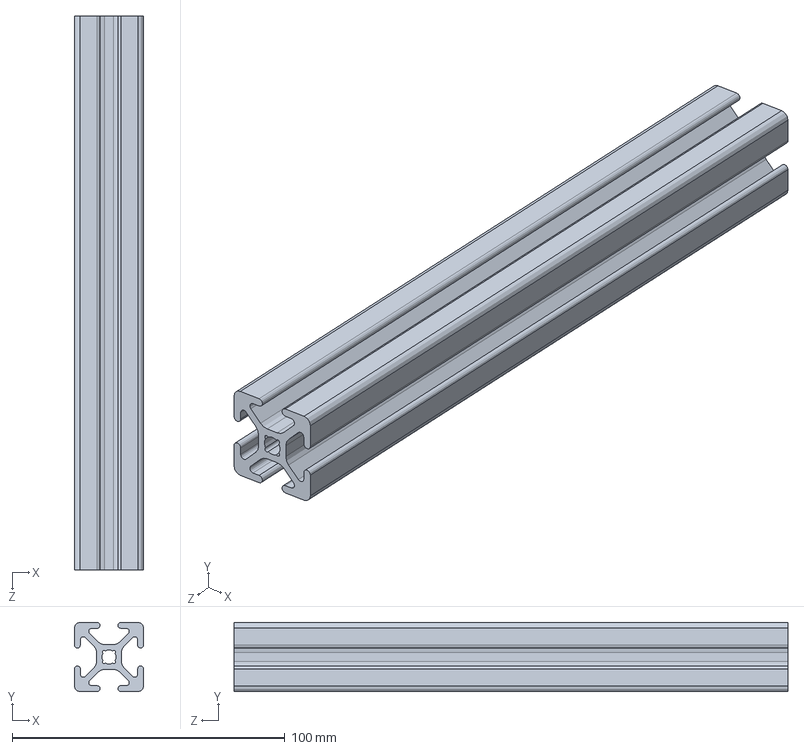
[picture p51: CAD file, 2024-03-27]
CAD_files/Stage/Railed_post.SLDPRT
25.4 x 25.4 x 203.2 mm
