PRDV1/Manual_BJP/CAD_files/IV. Heat_lamp/Heat_lamp_standholder.SLDPRT

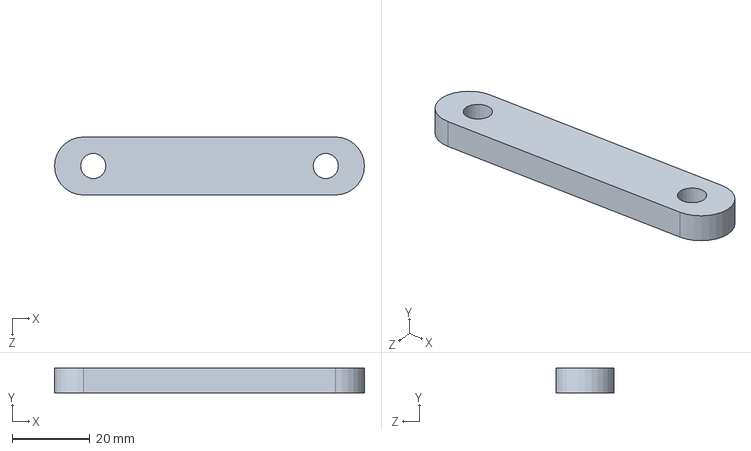
[picture p52: CAD file, 2024-03-27]
CAD_files/IV. Heat_lamp/Heat_lamp_standholder.SLDPRT
80.0 x 6.35 x 15.0 mm
