PRDV1/Manual_BJP/(list of files, cad)

Other CAD files:
STL_files/II. Ink-Cartridge_Top_Plate/Ink-Cartridge_top_plate_assembly-Powder_carriage_assembly-1 Powder_carriage.STL
CAD_files/III. Stage_Assembly/Pin_stage_assembly.SLDPRT
STL_files/III. Stage_Assembly/Stage_assembly-Stage_assembly_support_4108.STL
CAD_files/III. Stage_Assembly/Stage_assembly_slider_3382.SLDPRT
STL_files/Stage/Frame_assembly-support_4108.STL
STL_files/I. Spray_Top_Plate/Spray_top_plate_assembly-Powder_carriage_assembly-1 Brass_insert_powder_carriage.STL
STL_files/II. Ink-Cartridge_Top_Plate/Ink-Cartridge_top_plate_assembly-Powder_carriage_assembly-1 Felt_powder_carriage.STL
STL_files/III. Stage_Assembly/Stage_assembly-Stage_assembly_platform.STL
STL_files/III. Stage_Assembly/Stage_assembly-Stage_assembly_slider_3382.STL
CAD_files/I. Spray_Top_Plate/Powder_deposition_and_spreading/Felt_powder_carriage.SLDPRT
CAD_files/I. Spray_Top_Plate/Powder_recapture/Powder_catcher_short_both.SLDPRT
CAD_files/II. Ink-Cartridge_Top_Plate/Powder_deposition_and_spreading/Powder_carriage.SLDPRT
CAD_files/II. Ink-Cartridge_Top_Plate/Powder_recapture/Powder_catcher_short_both.SLDPRT
CAD_files/V. Transfer_Assembly/Transfer_slider.SLDPRT
CAD_files/I. Spray_Top_Plate/Powder_deposition_and_spreading/Powder_spreader_Spray.SLDPRT
CAD_files/I. Spray_Top_Plate/Powder_recapture/Powder_catcher_long_Spray.SLDPRT
CAD_files/II. Ink-Cartridge_Top_Plate/Ink-Cartridge_Top_Plate.SLDPRT
CAD_files/II. Ink-Cartridge_Top_Plate/Powder_deposition_and_spreading/Felt_powder_carriage.SLDPRT
CAD_files/III. Stage_Assembly/Build_bed_support.SLDPRT
CAD_files/I. Spray_Top_Plate/Powder_deposition_and_spreading/Brass_insert_powder_carriage.SLDPRT
CAD_files/II. Ink-Cartridge_Top_Plate/Powder_deposition_and_spreading/Felt_powder_spreader_Ink-Cartridge.SLDPRT
CAD_files/V. Transfer_Assembly/Transfer_box.SLDPRT
CAD_files/II. Ink-Cartridge_Top_Plate/Powder_deposition_and_spreading/Powder_spreader_Ink-Cartridge.SLDPRT
CAD_files/I. Spray_Top_Plate/Powder_deposition_and_spreading/Powder_carriage.SLDPRT
CAD_files/Stage/Base.SLDPRT
CAD_files/II. Ink-Cartridge_Top_Plate/Powder_deposition_and_spreading/Brass_insert_powder_carriage.SLDPRT
CAD_files/III. Stage_Assembly/Stee_ball.SLDPRT
CAD_files/I. Spray_Top_Plate/Powder_deposition_and_spreading/Felt_powder_spreader_Spray.SLDPRT
CAD_files/III. Stage_Assembly/Spring.SLDPRT
CAD_files/III. Stage_Assembly/Mitutoyo Micrometer 150-831.SLDPRT
CAD_files/III. Stage_Assembly/Stage_assembly_screw_3390.SLDPRT
CAD_files/IV. Heat_lamp/Bolt_heat_lamp.SLDPRT
CAD_files/Stage/Top_plate_screw_3955.SLDPRT
STL_files/III. Stage_Assembly/Stage_assembly-Stage_assembly_screw_3390.STL
STL_files/IV. Heat_lamp/Heat_lamp_assembly-Bolt_heat_lamp.STL
STL_files/Stage/Frame_assembly-Top_plate_screw_3955.STL
STL_files/Stage/Frame_assembly-screw_3390.STL
